dxu07/2.5-DOF-Pen-Plotter/docs/nerf_profile.jpg

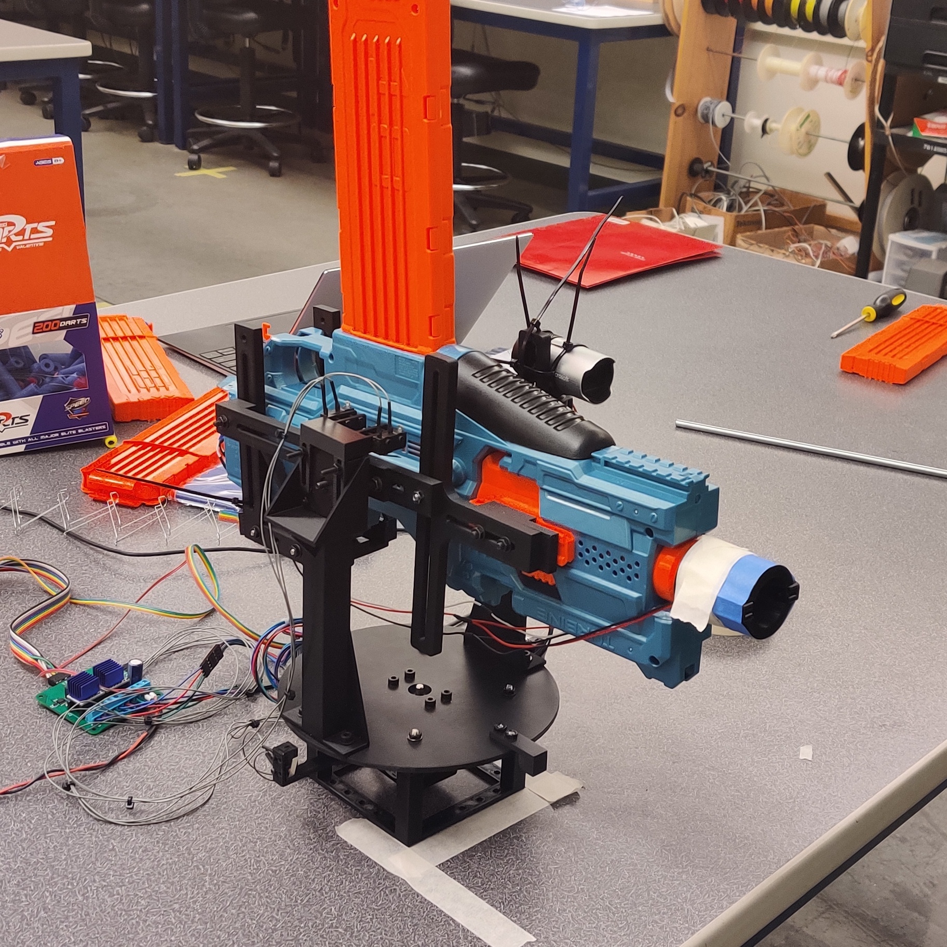
docs/nerf_profile.jpg
