dxu07/2.5-DOF-Pen-Plotter/docs/nerfgun.jpg

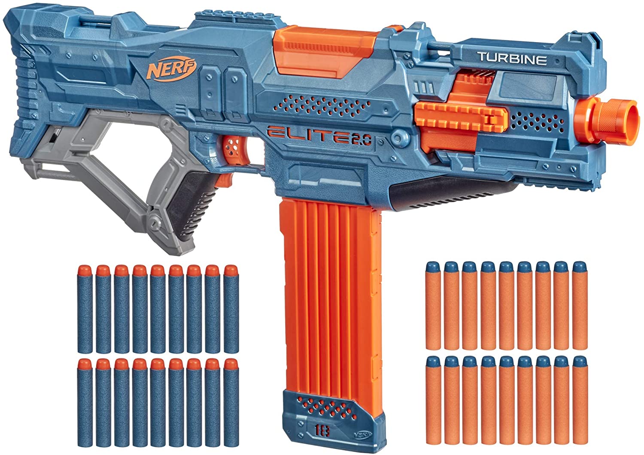
docs/nerfgun.jpg
