dxu07/2.5-DOF-Pen-Plotter/README.md

# ME-405-Term-Project
Project by Alex Radovan and Daniel Xu

This repository holds code and other supplemental materials for the ME 405 Term Project.

The documentation and report pages are at <https://dxu07.github.io/2.5-DOF-Pen-Plotter/>.
