dxu07/2.5-DOF-Pen-Plotter/latex/hierarchy.tex

\doxysection{Class Hierarchy}
This inheritance list is sorted roughly, but not completely, alphabetically\+:\begin{DoxyCompactList}
\item \contentsline{section}{task\+\_\+share.\+Base\+Share}{\pageref{classtask__share_1_1_base_share}}{}
\begin{DoxyCompactList}
\item \contentsline{section}{task\+\_\+share.\+Queue}{\pageref{classtask__share_1_1_queue}}{}
\item \contentsline{section}{task\+\_\+share.\+Share}{\pageref{classtask__share_1_1_share}}{}
\end{DoxyCompactList}
\item Exception\begin{DoxyCompactList}
\item \contentsline{section}{Nerf\+Driver.\+Barrel\+Jam}{\pageref{class_nerf_driver_1_1_barrel_jam}}{}
\item \contentsline{section}{Nerf\+Driver.\+Out\+Of\+Ammo}{\pageref{class_nerf_driver_1_1_out_of_ammo}}{}
\end{DoxyCompactList}
\item \contentsline{section}{Nerf\+Driver.\+Nerf}{\pageref{class_nerf_driver_1_1_nerf}}{}
\item \contentsline{section}{Stepper\+Driver.\+Stepper\+Driver}{\pageref{class_stepper_driver_1_1_stepper_driver}}{}
\item \contentsline{section}{cotask.\+Task}{\pageref{classcotask_1_1_task}}{}
\item \contentsline{section}{cotask.\+Task\+List}{\pageref{classcotask_1_1_task_list}}{}
\item \contentsline{section}{Stepper\+Driver.\+TMC2208}{\pageref{class_stepper_driver_1_1_t_m_c2208}}{}
\item \contentsline{section}{Stepper\+Driver.\+TMC4210}{\pageref{class_stepper_driver_1_1_t_m_c4210}}{}
\end{DoxyCompactList}
