dxu07/2.5-DOF-Pen-Plotter/latex/task__share_8py.tex

\hypertarget{task__share_8py}{}\doxysection{src/pyb/task/task\+\_\+share.py File Reference}
\label{task__share_8py}\index{src/pyb/task/task\_share.py@{src/pyb/task/task\_share.py}}

This file contains classes which allow tasks to share data without the risk of data corruption by interrupts.  

\doxysubsection*{Classes}
\begin{DoxyCompactItemize}
\item 
class \mbox{\hyperlink{classtask__share_1_1_base_share}{task\+\_\+share.\+Base\+Share}}
\begin{DoxyCompactList}\small\item\em Base class for queues and shares which exchange data between tasks. \end{DoxyCompactList}\item 
class \mbox{\hyperlink{classtask__share_1_1_queue}{task\+\_\+share.\+Queue}}
\begin{DoxyCompactList}\small\item\em A queue which is used to transfer data from one task to another. \end{DoxyCompactList}\item 
class \mbox{\hyperlink{classtask__share_1_1_share}{task\+\_\+share.\+Share}}
\begin{DoxyCompactList}\small\item\em An item which holds data to be shared between tasks. \end{DoxyCompactList}\end{DoxyCompactItemize}
\doxysubsection*{Functions}
\begin{DoxyCompactItemize}
\item 
def \mbox{\hyperlink{task__share_8py_a130cad0bc96d3138e77344ea85586b7c}{task\+\_\+share.\+show\+\_\+all}} ()
\begin{DoxyCompactList}\small\item\em Create a string holding a diagnostic printout showing the status of each queue and share in the system. \end{DoxyCompactList}\end{DoxyCompactItemize}
\doxysubsection*{Variables}
\begin{DoxyCompactItemize}
\item 
list \mbox{\hyperlink{task__share_8py_a75818e5b662453e3723d0f234c85e519}{task\+\_\+share.\+share\+\_\+list}} = \mbox{[}$\,$\mbox{]}
\begin{DoxyCompactList}\small\item\em This is a system-\/wide list of all the queues and shared variables. \end{DoxyCompactList}\item 
dictionary \mbox{\hyperlink{task__share_8py_a20669bcd5137496d47c279196fd7fbc5}{task\+\_\+share.\+type\+\_\+code\+\_\+strings}}
\begin{DoxyCompactList}\small\item\em This dictionary allows readable printouts of queue and share data types. \end{DoxyCompactList}\end{DoxyCompactItemize}

\doxysubsection{Detailed Description}
This file contains classes which allow tasks to share data without the risk of data corruption by interrupts. 

\begin{DoxyAuthor}{Author}
JR Ridgely 
\end{DoxyAuthor}
\begin{DoxyDate}{Date}
2017-\/Jan-\/01 JRR Approximate date of creation of file 

2021-\/Dec-\/18 JRR Docstrings changed to work without Doxy\+Py\+Py 
\end{DoxyDate}
\begin{DoxyCopyright}{Copyright}
This program is copyright (c) 2017-\/2021 by JR Ridgely and released under the GNU Public License, version 3.\+0.
\end{DoxyCopyright}
It is intended for educational use only, but its use is not limited thereto. THIS SOFTWARE IS PROVIDED BY THE COPYRIGHT HOLDERS AND CONTRIBUTORS \char`\"{}\+AS IS\char`\"{} AND ANY EXPRESS OR IMPLIED WARRANTIES, INCLUDING, BUT NOT LIMITED TO, THE IMPLIED WARRANTIES OF MERCHANTABILITY AND FITNESS FOR A PARTICULAR PURPOSE ARE DISCLAIMED. IN NO EVENT SHALL THE COPYRIGHT OWNER OR CONTRIBUTORS BE LIABLE FOR ANY DIRECT, INDIRECT, INCIDENTAL, SPECIAL, EXEMPLARY, OR CONSEQUENTIAL DAMAGES (INCLUDING, BUT NOT LIMITED TO, PROCUREMENT OF SUBSTITUTE GOODS OR SERVICES; LOSS OF USE, DATA, OR PROFITS; OR BUSINESS INTERRUPTION) HOWEVER CAUSED AND ON ANY THEORY OF LIABILITY, WHETHER IN CONTRACT, STRICT LIABILITY, OR TORT (INCLUDING NEGLIGENCE OR OTHERWISE) ARISING IN ANY WAY OUT OF THE USE OF THIS SOFTWARE, EVEN IF ADVISED OF THE POSSIBILITY OF SUCH DAMAGE. 

\doxysubsection{Function Documentation}
\mbox{\Hypertarget{task__share_8py_a130cad0bc96d3138e77344ea85586b7c}\label{task__share_8py_a130cad0bc96d3138e77344ea85586b7c}} 
\index{task\_share.py@{task\_share.py}!show\_all@{show\_all}}
\index{show\_all@{show\_all}!task\_share.py@{task\_share.py}}
\doxysubsubsection{\texorpdfstring{show\_all()}{show\_all()}}
{\footnotesize\ttfamily def task\+\_\+share.\+show\+\_\+all (\begin{DoxyParamCaption}{ }\end{DoxyParamCaption})}

Create a string holding a diagnostic printout showing the status of each queue and share in the system. 

\begin{DoxyReturn}{Returns}
A string containing information about each queue and share 
\end{DoxyReturn}

\doxysubsection{Variable Documentation}
\mbox{\Hypertarget{task__share_8py_a75818e5b662453e3723d0f234c85e519}\label{task__share_8py_a75818e5b662453e3723d0f234c85e519}} 
\index{task\_share.py@{task\_share.py}!share\_list@{share\_list}}
\index{share\_list@{share\_list}!task\_share.py@{task\_share.py}}
\doxysubsubsection{\texorpdfstring{share\_list}{share\_list}}
{\footnotesize\ttfamily list task\+\_\+share.\+share\+\_\+list = \mbox{[}$\,$\mbox{]}}

This is a system-\/wide list of all the queues and shared variables. 

It is used to create diagnostic printouts. \mbox{\Hypertarget{task__share_8py_a20669bcd5137496d47c279196fd7fbc5}\label{task__share_8py_a20669bcd5137496d47c279196fd7fbc5}} 
\index{task\_share.py@{task\_share.py}!type\_code\_strings@{type\_code\_strings}}
\index{type\_code\_strings@{type\_code\_strings}!task\_share.py@{task\_share.py}}
\doxysubsubsection{\texorpdfstring{type\_code\_strings}{type\_code\_strings}}
{\footnotesize\ttfamily dictionary task\+\_\+share.\+type\+\_\+code\+\_\+strings}

{\bfseries Initial value\+:}
\begin{DoxyCode}{0}
\DoxyCodeLine{1 =  \{\textcolor{stringliteral}{'b'} : \textcolor{stringliteral}{"{}int8"{}},   \textcolor{stringliteral}{'B'} : \textcolor{stringliteral}{"{}uint8"{}},}
\DoxyCodeLine{2                      \textcolor{stringliteral}{'h'} : \textcolor{stringliteral}{"{}int16"{}},  \textcolor{stringliteral}{'H'} : \textcolor{stringliteral}{"{}uint16"{}},}
\DoxyCodeLine{3                      \textcolor{stringliteral}{'i'} : \textcolor{stringliteral}{"{}int(?)"{}}, \textcolor{stringliteral}{'I'} : \textcolor{stringliteral}{"{}uint(?)"{}},}
\DoxyCodeLine{4                      \textcolor{stringliteral}{'l'} : \textcolor{stringliteral}{"{}int32"{}},  \textcolor{stringliteral}{'L'} : \textcolor{stringliteral}{"{}uint32"{}},}
\DoxyCodeLine{5                      \textcolor{stringliteral}{'q'} : \textcolor{stringliteral}{"{}int64"{}},  \textcolor{stringliteral}{'Q'} : \textcolor{stringliteral}{"{}uint64"{}},}
\DoxyCodeLine{6                      \textcolor{stringliteral}{'f'} : \textcolor{stringliteral}{"{}float"{}},  \textcolor{stringliteral}{'d'} : \textcolor{stringliteral}{"{}double"{}}\}}

\end{DoxyCode}

This dictionary allows readable printouts of queue and share data types.
