dxu07/2.5-DOF-Pen-Plotter/docs/back_nerf.jpg

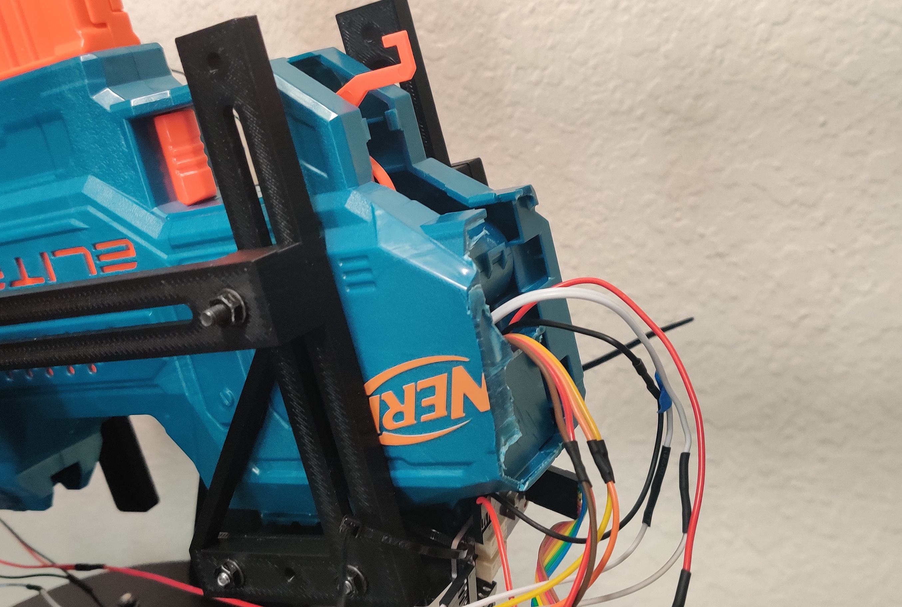
docs/back_nerf.jpg
