dxu07/2.5-DOF-Pen-Plotter/docs/CAD.png

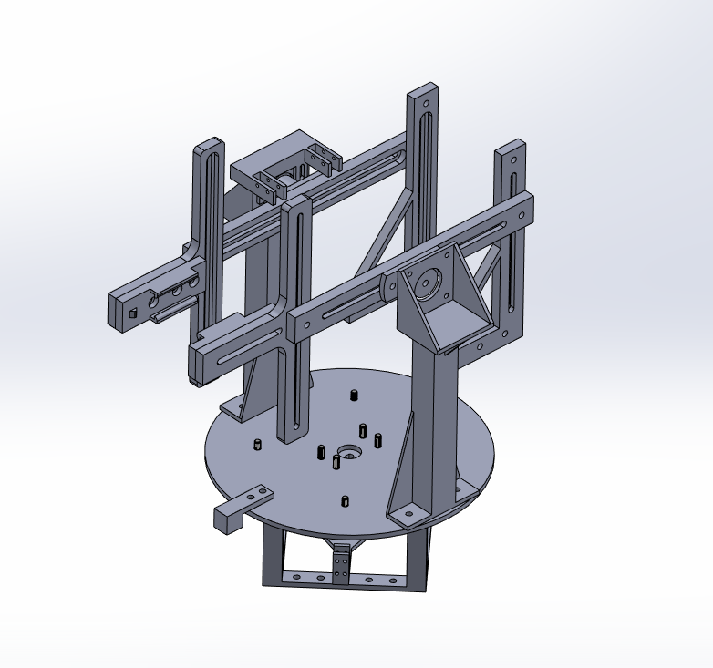
docs/CAD.png
