dxu07/2.5-DOF-Pen-Plotter/docs/drawing_comp.png

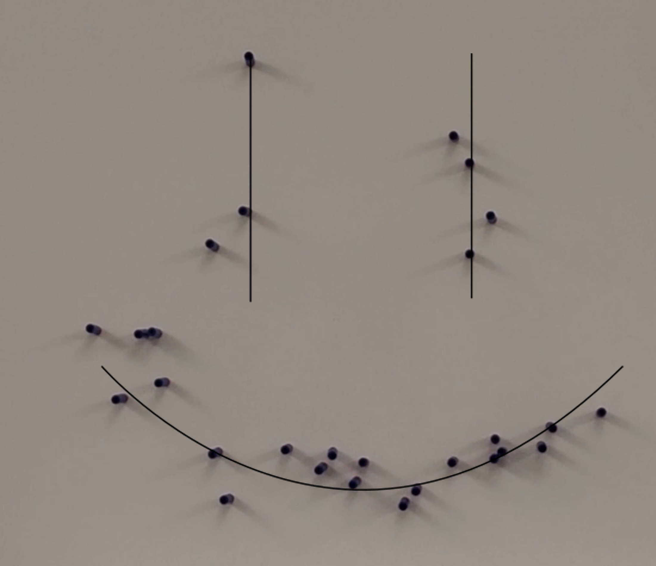
docs/drawing_comp.png
