dxu07/2.5-DOF-Pen-Plotter/docs/equation.png

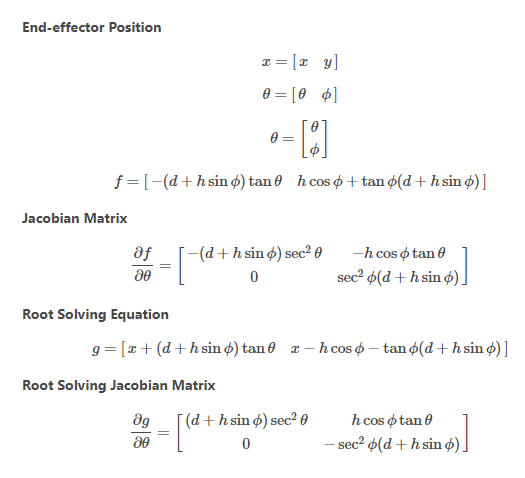
docs/equation.png
