dxu07/2.5-DOF-Pen-Plotter/docs/side.png

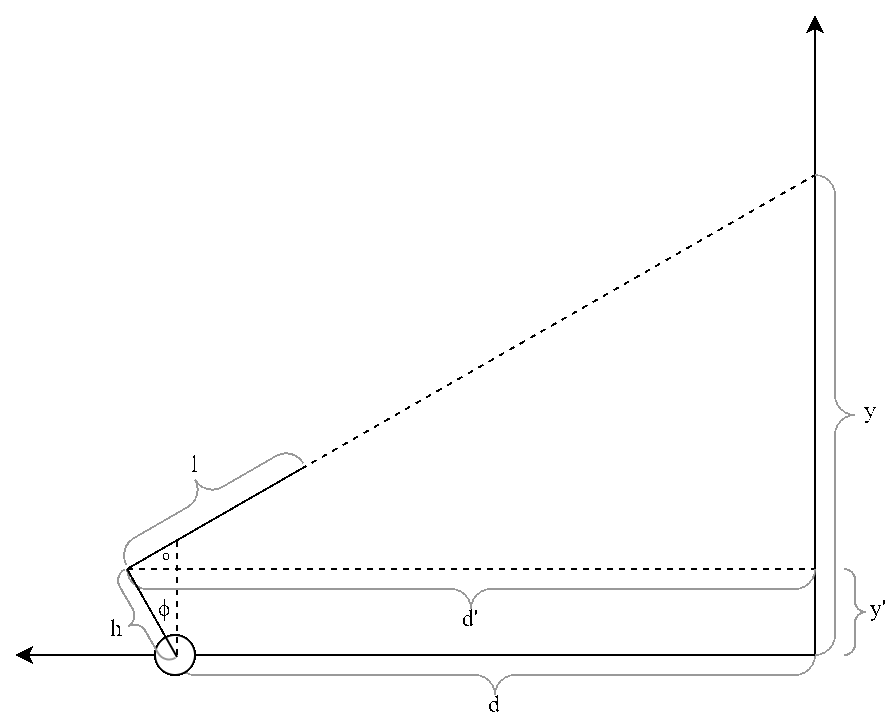
docs/side.png
