dxu07/2.5-DOF-Pen-Plotter/docs/task_diagram.png

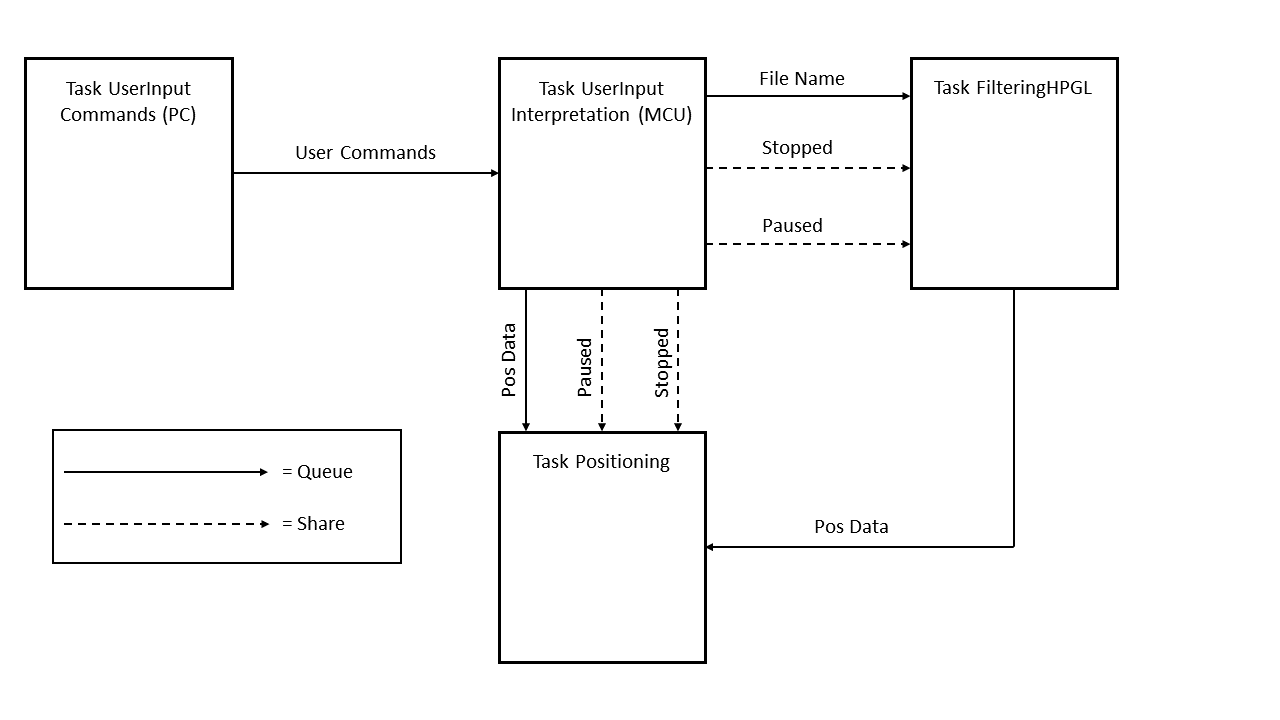
docs/task_diagram.png
