dxu07/2.5-DOF-Pen-Plotter/docs/top.png

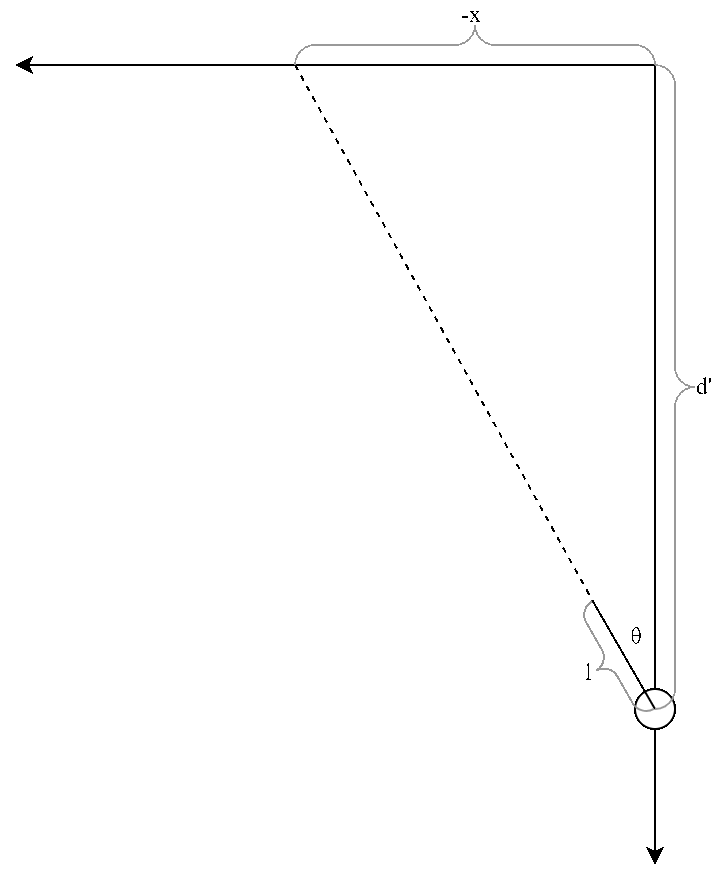
docs/top.png
