dxu07/2.5-DOF-Pen-Plotter/figs/20220609_223617.jpg

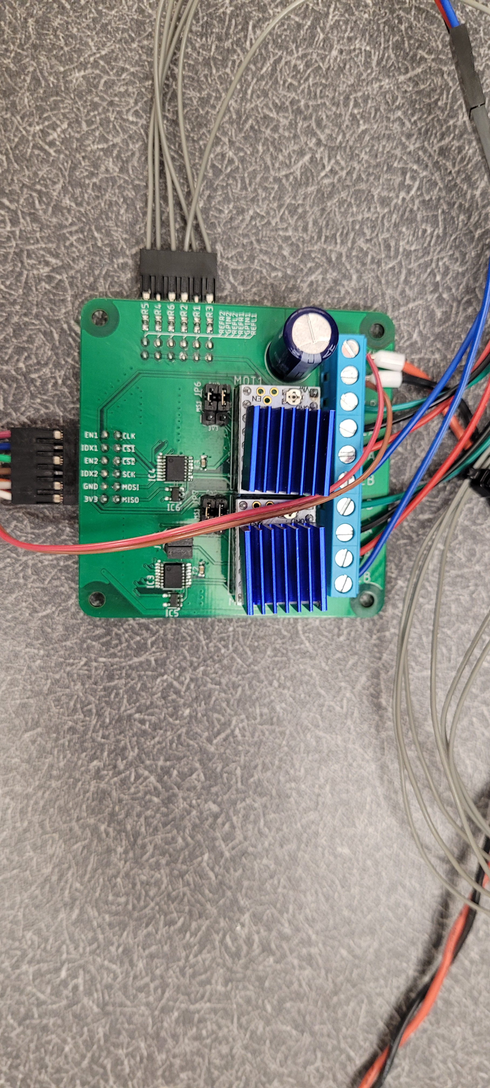
figs/20220609_223617.jpg
