dxu07/2.5-DOF-Pen-Plotter/figs/nerf_schematic.pdf

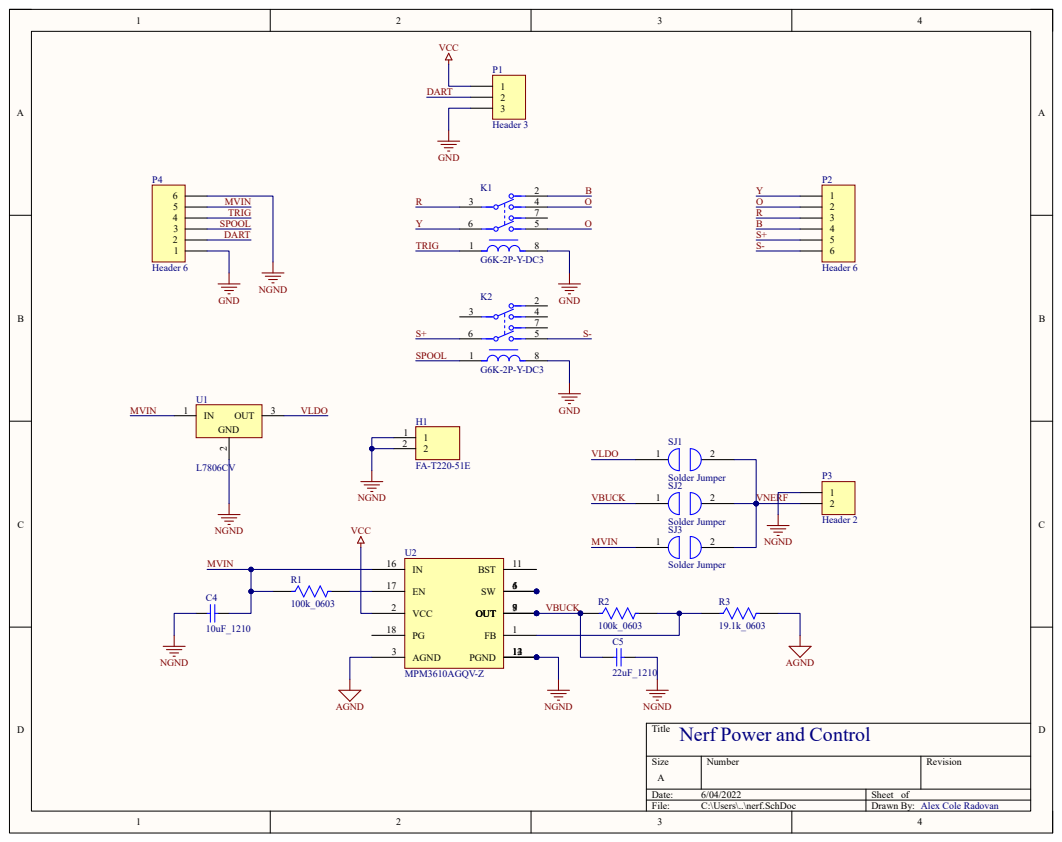
[picture p15: page 1]

NGND
Nerf Power and Control
