dxu07/2.5-DOF-Pen-Plotter/figs/nerf_pcb.pdf

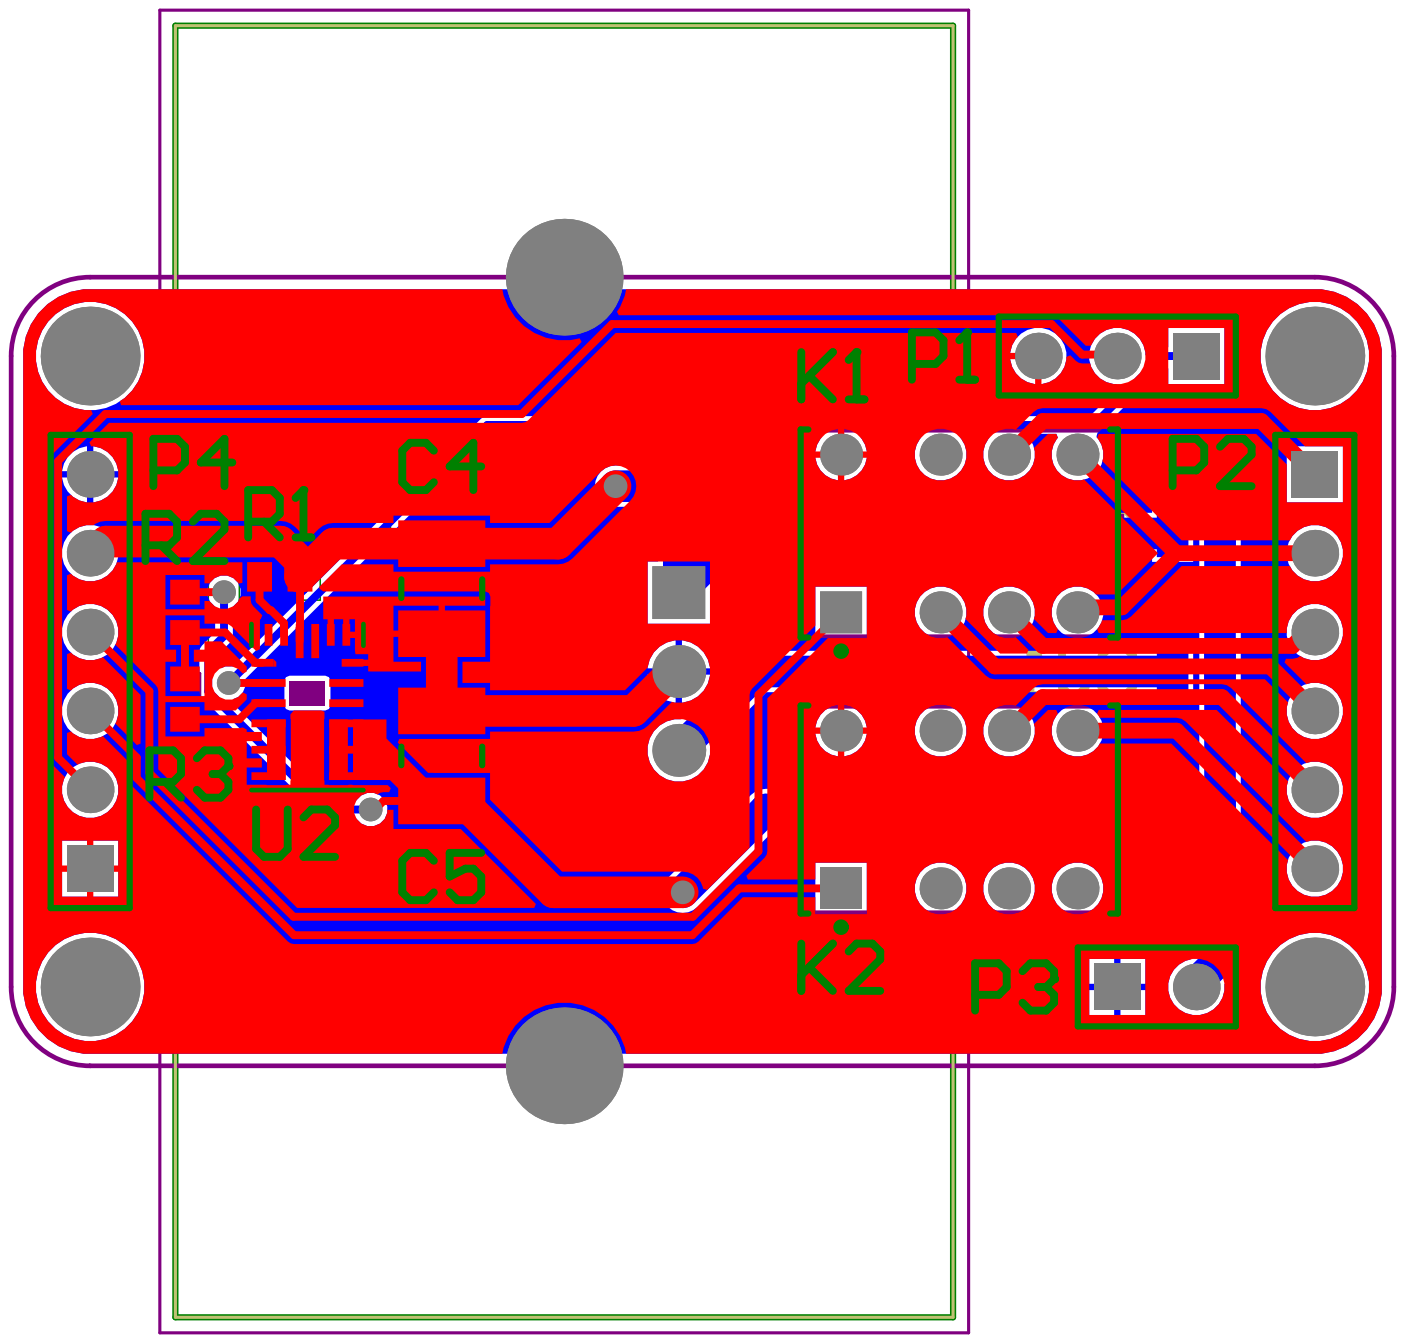
[picture p16: page 1]
