dxu07/2.5-DOF-Pen-Plotter/(list of files, drawings)

Other design files:
eda/nerf.PcbDoc
eda/nerf.PrjPcb
eda/nerf.SchDoc
